db-electronics/kicadlib/README.md

# KiCad Library
This project contains KiCad schematic and footprint components use throughout my KiCad projects. It also contains KiCad project templates and BOM generating scripts.

# Support Open Source
If you're going to use my free projects please consider sponsoring my work. Thanks!

- [Github Sponsor](https://github.com/sponsors/db-electronics)
- [Pateron](https://patreon.com/dbelectronics)

# Copyright and Disclaimer
Copyright: René Richard

This documentation describes Open Hardware and is licensed under the
CERN OHL v. 1.2.

You may redistribute and modify this documentation under the terms of the
CERN OHL v.1.2. (http://ohwr.org/cernohl). This documentation is distributed
WITHOUT ANY EXPRESS OR IMPLIED WARRANTY, INCLUDING OF
MERCHANTABILITY, SATISFACTORY QUALITY AND FITNESS FOR A
PARTICULAR PURPOSE. Please see the CERN OHL v.1.2 for applicable
conditions
