db-electronics/kicadlib/db-billboard-large.png

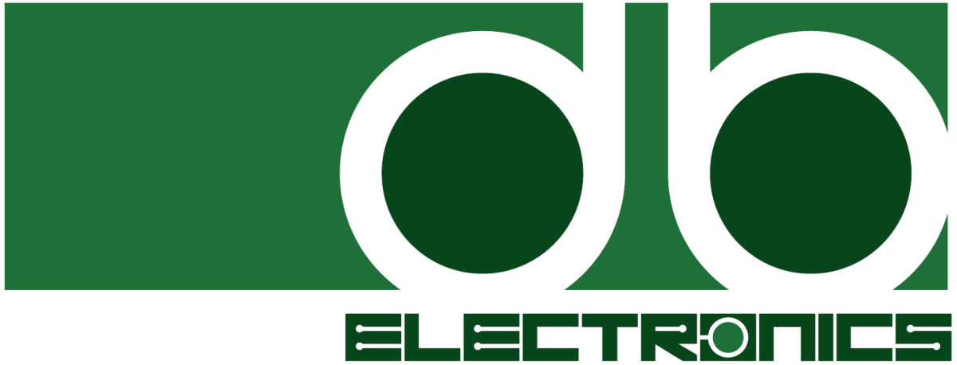
db-billboard-large.png
