db-electronics/kicadlib/(commit log)

2016-01-05 segregated the kicad library into its own repo
2016-08-17 getting used to KiCad again
2017-02-09 new footprints
2017-03-08 added TSSOP-48 footprint
2018-01-16 added new 3.3V 32Mbit flash, snes connector
2018-01-18 added SNES connector footprint
2018-01-19 added tssop-14 footprint
2018-01-25 fixing resistor and capacitor symbol fields
2018-01-26 library work, started NES connector but not finished
2018-01-26 created NES connector
2018-01-29 new SNES edge footprint, no expansion pins
2018-01-30 fixed the pin numbering on the SNES-CONN-EXP
2018-01-31 added new logo to footprints
2018-03-08 shrunk PCB size for C64
2018-03-09 improved several footprints
2018-03-12 fix pin # error on hc174
2018-03-28 added bom generator script
2018-03-28 fixed diode and transistor symbols
2018-04-04 library work, few new footprints
2018-04-06 added Genesis connector and PIC32MX795 part
2018-04-19 new TSSOP-32 footprint
2018-04-19 renamed HuCard footprint for consistency
2018-05-05 creating footprints
2018-08-02 increased hole size on MD-90SM
2018-09-04 improved diode symbol, created pic32mx795 100 pin version
2018-09-04 more pins on the pic32mx795 100-tqfp footprint
2018-09-05 added missing PMP pins to pic32mx795, new UMDv2 connector symbol
2018-09-06 new MCP23008 part and footprint SOIC-18, changed pinout of UMDv2 conn
2018-09-06 changed footprint SSOP-48 to BSSOP-48 to match Digikey's naming
2018-09-07 added new USB connector footprint
2018-09-09 new part - USB ESD diode
2018-09-09 better diode symbols
2018-09-10 added uUSB connector and SC-74A footprints
2018-09-10 removed MAX ideal diode
2018-09-11 new footprint SOT-363, new part current sense amp
2018-09-17 changed pad size on TSSOP-48 from 0.3mm to 0.28mm
2018-09-18 new footprint for 4x20 char lcd
2018-09-21 fixed pin count on HDR1X16 for lcd
2018-10-17 created footprint and part for SMS-EDGE
2018-10-17 new flash symbols and work on SMS-EDGE footprints
2018-10-17 new footprint for MAX V CPLD
2018-10-18 added board outline to SMS-EDGE
2018-10-18 added JTAG 2x5 connector footprint
2018-10-24 new CR2032 holder footprint
2018-10-25 low profile battery retainer
2018-11-03 new BGA-484 footprint
2018-11-06 new LEDs
2018-11-07 new tactile switch footprint
2018-11-12 changed 1 GND pin to Vcc for improved Vcc coverage
2018-11-16 added footprint for SMS connector
2018-11-16 new 4-40 screw footprint
2018-11-18 LQFP-144 footprint
2018-11-29 started new symbol for STM32F407Z
2018-11-30 more work on STM32F407Z symbol
2018-12-08 work on STM32 symbol
2019-01-07 placed every pin on STM32F407
2019-01-11 new JTAG 2x10 connector
2019-01-15 updating UMDv2 footprint
2019-01-15 new power symbols
2019-01-17 optimizing pin placement on the UMDv2 connector
2019-01-24 new footprint for shrouded 2x10 JTAG
2019-01-29 changed USB power switch to active-high part #
2019-02-12 new symbol (not finished) for STM32F413 144LQPF
2019-02-13 finished symbol for STM32F413
2019-02-20 added hard-gold plated receptacle as part# for UMDv2 connector
2019-02-22 new SOD123 footprint
2019-02-28 new footprint for UMD LA connection
2019-03-02 new UMD-CONN footprint with integrated test points for all signals
2019-03-02 added 4-40 screw symbol
2019-03-04 added symbols for a logo, easier when updating PCB
2019-03-26 created python script to extract pin tables from .lib
    [STM32F413ZHT6_pins.csv]
2019-03-29 updated UMDv2 symbol and footprint, changed AN0-AN1 to A24, A25
2019-03-30 added 3 pins as key to UMDv2 connector
2019-04-01 changed UMDv2 connector again
2019-04-03 increased spacing on UMDv2 connector
2020-02-19 new resistor network
2020-02-29 adding new STM32F412 symbol
2020-03-01 STM32F412 symbol work
2020-03-05 added larger SMS cartridge footprint
2020-03-05 finished new STM32F412 symbol, new LQFP-144-PAD footprint
2020-03-06 fixed export_pin_table.py script, MAX10 10M04 footprint validated
    [STM32F413ZHT6_pins.csv]
2020-03-22 new footprint, fixed lqfp-144, new 74lvc symbols
2020-03-22 new 74lvc06 and uSD footprint
2020-03-22 added 0.050 2x5 SWD connector
2021-05-26 new footprint
2021-05-26 fixed typo in 2x20 2mm description
2021-05-27 db9 connector
2021-11-25 new tssop-56 footprint
2021-12-07 adding new stm32f407ve mcu
2021-12-17 fixed board outline on SNES edge
2021-12-27 n64 connector and edge
2021-12-28 all pins added to stm32f407vet6
2021-12-28 arranged stm32f407vet6 pins
2021-12-29 change n64 cic pin name
2021-12-29 pinout review for stm32f407vet6
2022-01-08 fixed sdcard footprint
2022-01-15 reduced SMS pcb width by 6mil on both edge conns
2022-01-16 new diode
2022-01-18 new xtal hc-49 footprint
2022-01-20 new umdv3 footprint, mostly backwards compatible
2022-01-21 added 3.3V i2c display
2023-10-11 new footprint, z80
2023-10-16 fixed pin on hc193
2023-10-19 new 3mm leds
2023-10-22 added din5 MIDI connector
2023-10-28 0.96 inch i2c display
2023-12-16 added gba connector
2023-12-22 gba pcb edge
2023-12-22 updated GBA pcb edge
2023-12-29 fix flash footprints
2024-01-23 fixed some 74hc footprints
2024-03-02 updated cap footprint
2024-03-08 fixed gba pin pitch
2024-03-08 fixed gba pin pitch for pcb edge
2024-03-10 new gba conn footprint
2024-03-10 1.5mm gba again
2024-03-17 fixed soldermask expansion on snes connector
2024-04-10 remove old KiCad files from library, update template and BOM
    [template.kicad_pcb]
